minwu85/MQ_Sentinel/CAD/MQ_Sentinel_Encoder_Housing_Dimensions.txt

MQ Sentinel Encoder Housing - Revision 21 (frame unchanged from rev 20; inserts without bars, with wall holes)
All dimensions 1:1 mm (generated by encoder_housing.py, lid.py, motor_ref.py)

OVERALL
Housing height: 133.0 (platform 3 top). With the cap: 170.0 (the 170 mm pipe limit, Appendix 1)
Sensor ring centreline: Z 130.0 (40.0 below the 170.0 top)
Widest part: 160.0 (platform 0, R80)

PLATFORM 0: OD 160.0, thickness 5.0 (Z 0.0 to 5.0)
PLATFORM 1: OD 150.0, thickness 5.0 (Z 5.0 to 10.0), top flat; 10.0 centre hole through both
Underside pockets for the insert plates (2.0 thick; insert_minus1.step, insert_minus2.step):
  Platform -1 plate (Z 0.0 to 2.0): centre circle 50.0 + two wedges at 0 / 180 deg, 60 deg wide
  Platform -2 plate (Z 2.0 to 4.0): centre circle 60.0 + two wedges at 90 / 270 deg, 60 deg wide
  Pocket Z 0.0 to 2.0 is the union of both shapes (plate -2 is fitted from below first)

LOWER POSTS: 4 at 45 / 135 / 225 / 315 deg, 10.0 wide x 14.0 radial, radius 67.5, Z 9.0 to 85.0
PLATFORM 2 (MIDDLE DECK): OD 150.0, thickness 5.0 (Z 85.0 to 90.0)
  X cross: arms on the 45 / 135 deg diagonals, 36.0 wide
  Four axis wedges cut away to R71.0, leaving a 4.0 wide rim (stronger than the old 1.5)
UPPER POSTS: 4 at 45 / 135 / 225 / 315 deg, 10.0 wide x 14.0 radial, radius 67.5, Z 90.0 to 127.0 (37.0 tall)

PLATFORM 3 (TOP SENSOR RING): OD 150.0, ID 120.0, thickness 6.0 (Z 127.0 to 133.0), always complete
  Screw holes: 4 x dia 3.0 at radius 67.5 (45 / 135 / 225 / 315 deg)
  Sensor notches: 3 at 0 / 120 / 240 deg, 8.0 x 7.0 (radial from outer edge) x 6.0 through
  Quarter-turn thread: 4 internal ridge sections centred on 45 / 135 / 225 / 315 deg, each 70 deg wide
    (gaps of 20 deg at 0 / 90 / 180 / 270), pitch 4.0, base radius 60.1, tip radius 58.5

MOTOR SLEEVE: bore 38.0, wall 3.0, OD 44.0, Z 51.0 to 95.0 (44.0 tall), closed 3.0 bottom
  Wire window 10.0 wide x 20.0 tall, front (-Y), Z 54.0 to 74.0

CAP (lid.step), four-section screw cap, Z 123.0 to 170.0
  Top disc: OD 150.0, 4.0 thick (Z 166.0 to 170.0), 4 x dia 3.0 holes at radius 67.5, 20.0 x 8.0 finger slot
  Shell: OD 150.0, wall 3.0, Z 136.0 to 166.0
  Flange on the ring: OD 150.0, 3.0 thick (Z 133.0 to 136.0)
  Threaded skirt: OD 116.0, ID 110.0, Z 123.0 to 133.0 (10.0 long)
  Thread: 4 external ridge sections, each 16 deg wide, pitch 4.0, base radius 57.9, tip radius 59.7
  Drop-in: turn the cap so its sections sit on the axes, push down through the ring gaps, then turn 45 deg
  No raised handle (170 mm limit)

MOTOR (reference, motor_ref.step; measured values)
Overall Z 54.0 to 145.0 (91.0): encoder cap dia 36.0 x 12.0; grey body dia 35.0 x 57.0; boss dia 12.0 x 6.0; shaft dia 6.0 x 16.0
Flywheel dia 100.0 x 10.0, Z 129.0 to 139.0

CHECKS
Interference (all 0.0 mm3): housing/motor, cap/motor, cap/housing seated, cap/housing in drop-in orientation, inserts/housing
Appendix 1: housing + cap 170.0, widest 160.0 (R80)

INSERTS (inserts.py): YOKE PLATFORM -1 (insert_minus1.step) and PLATFORM -2 (insert_minus2.step), v17 form, run after the frame
  Platform -1: round plate dia 50.0 + two 60 deg arms (0 / 180 deg) to R57.0, 2.0 thick, Z 10.0 to 12.0, 10.0 centre hole
  Platform -2: round plate dia 60.0 + two 60 deg arms (90 / 270 deg) to R57.0, 2.0 thick, Z 12.0 to 14.0, 10.0 centre hole
  Curved side walls ("handles"): R54.0 to 57.0, 44 deg wide, up to Z 165.0 (side height 165), 32.0 above the ring top
    (moved in from R66-69 so they pass inside the sensor ring bore R60; narrower to clear the deck X arms)
  Top bars: removed
  Wall holes: 1 hole in each wall (2 per yoke), 20.0 wide x 10.0 tall (2 x 1 cm), for a block through both walls
    Platform -1: Z 150.0 to 160.0 (centre 155.0), in the walls at 0 / 180 deg
    Platform -2: Z 135.0 to 145.0 (centre 140.0), in the walls at 90 / 270 deg; holes of the two yokes are 5.0 apart in height
  Interference with the frame, each other and the motor reference: 0.0 mm3

REVISION 22 (2026-10-24) CHANGES - these override the lines above where they differ
  Posts: 4 lower + 4 upper, 20 x 20 (R55-75, last 5 mm under the ring R60-75); deck rim 15 wide (R60-75) + flange R69-75 z80-85
  Platform 0/1 centre hole 21.0; arc slots R44-55 +-20 deg at 0/90/180/270 (insert walls)
  Motor sleeve: bore 38 z54-85, collar bore 36 z85-97 (top 97, was 95)
  CAP: top z177 (shell z136-173, disc z173-177); keyhole entry dia 10 / slot 5.5 / head pocket 10.4 x 4.5; boss 30 x 60 x 12; 4 ribs 4 x 10;
       8 x dia 3.4 holes (cbore 6.5) at R49.5, +-12 deg from 0/90/180/270; finger slot removed
  INSERTS: plates z0-2 (-1, both shapes) and z2-4 (-2), arms to R80 (160 wide), hole 21; walls R44.5-54.5 +-19 deg, top z173 (R50.5-54.5 at z127-141);
       belts R34.5-44.5 at z14-34, 100-120, 147-167; 20 x 10 holes (z150-160 / z135-145); 2 pilot holes dia 2.6 in each wall top
  LASER STRAW: A hollow bolt (flange 34 z10-13, tube OD 18/20 thread, bore 10, z-14 to 10); B nut dia 34 z-10 to 0, pitch 2.5
  Interference (all 0.0 mm3): every pair of housing, cap, inserts, straw parts, motor/flywheel reference

REVISION 23 (2026-10-24, second pass) - overrides revision 22 where it differs. 4 parts: lid, encoder_housing, insert, laser
  CAP: top z197 (disc z191-197), shell z136-191, no holes, no inner support; 4 ears R70-91.3 +-12 deg on the diagonals with 1 x dia 3.4 hole each (R85.3);
       arch hanger on a 44 x 18 x 3 pad: 32 wide, legs 8, 10 thick, opening 16 x 14, top z222
  ENCODER: arc slots removed; pocket under platform 0 = circle 60 + 4 arms +-30 deg on 45/135/225/315, 4 deep;
       centre socket hole R10.4 (z0-10) with female ridge z4-10, pitch 2.5, root R10.4, tip R8.4
  INSERT (one part): plate 4 thick (circle 60 + 4 arms to R90.3), hole dia 20.8; 4 walls R80.3-90.3, +-9 deg at 45/135/225/315, z0-190.7; pilot dia 2.6 x 15 at R85.3
  LASER: stub core R8 / ridge R10, bore 8, z0-10; flange dia 30 z-3..0; column dia 20; tube along +X OD 16.5, bore 10.5, 70 long, axis z-16; points at 0 deg (sensor 1)
  Interference (all 0.0 mm3): housing, lid, insert, laser, motor/flywheel reference, 172 mm pipe on platform 0

REVISION 24 (2026-10-25) - overrides revision 23 where it differs
  CAP: flange 6 thick (z133-139), 4 pilot holes dia 2.6 at R63.5, 0/90/180/270; ears R73-91.3 +-10 deg at z177.3-183.3, hole dia 5.5 (cbore 10) at R85.3;
       hanger pad 24 x 10 x 3, block 18 x 8 x 14, keyhole dia 8 + slot 4.5; top z197, hanger top z214
  ENCODER: upper posts R60-75 (z90-127); ring holes dia 3.4 at R63.5, 0/90/180/270 (plus the original 4 at R67.5, 45 deg)
  INSERT: walls +-7 deg, z0-177, pilot dia 4.2 x 20 at R85.3
  LASER: tube axis z-20 (150 below the ring centreline z130), slot 6 x 42 on top, grub hole at x63

REVISION 25 (2026-10-25, second pass) - overrides revision 24 where it differs
  RING + CAP FLANGE: 3 holes dia 5.5 at R67.5, 60/180/300 deg (old 45 deg and 0/90/180/270 holes removed); cap ears +-13 deg
  INSERT: walls +-10 deg; mid ring R80.3-90.3 z78.5-98.5; plate hole with female thread z0-4 (same helix as the encoder socket z4-10)
  LASER: side window 6 x 42 through both sides at the axis (z-20), plus the top slot

REVISION 26 (2026-10-25, third pass) - overrides revision 25 where it differs
  INSERT: walls 45 mm wide (+-15.3 deg at R85.3) at 45/150/210/315 deg; plate arms +-20 deg at the same angles; thread in the plate hole z0-4 (153 mm3)
  ENCODER: underside pocket arms +-20 deg at 45/150/210/315; socket thread z4-10 (230 mm3); ring holes unchanged (60/180/300)
  CAP: ears +-18.5 deg at 45/150/210/315
  LASER: top slot removed; side window and grub hole only

REVISION 27 (2026-10-25): laser = v25 (top slot + side window), stub top z13 (3 mm lead-in); all other parts as revision 26

REVISION 28 (2026-10-30)
  ENCODER: height 140; sensor ring z134-140 (centre z137 = 40 below the pipe top z177); upper posts z90-134
  CAP: seat z140 (flange z140-146), top z197 unchanged, ears z177.3-183.3 unchanged
  INSERT: wall + mid ring R81.3-90.3 (was R80.3)
  LASER: tube axis z-13 (150 below the ring centre)
