minwu85/MQ_Sentinel/src/flowchart.md

## Appendix H — Individual Contribution Graph

Min:

```text
WEEK 1–2
│
├── Scrum / project organisation
├── Arduino / C++ / PlatformIO setup
├── Software approach investigation
└── Initial project documentation
|      │
       ▼
WEEK 3
│
├── Motor / encoder testing
├── Motor connectivity test
├── Continuous motor control
└── Hardware-independent software structure
└── Scrum/project documentation
        │
        ▼
WEEK 4
│
├── Motor direction control
├── Motor speed / PWM control
├── Motor-driver troubleshooting
├── IR-reactive motor control
└── IR trigger / transmitter-receiver test
└── Scrum/project documentation
        │
        ▼
WEEK 5
│
├── Arduino Uno backup development
├── IR-reactive testing
├── IR-triggered motor testing
├── Three-sensor directional control
├── Technical documentation
└── Scrum/project documentation
        │
        ▼
PROTOTYPE V1
│
└── Software foundation:
      IR sensing
          ↓
      Decision logic
          ↓
      Motor direction/speed
          ↓
      Physical prototype integration

```
**Figure H2. Individual software and project-documentation contribution progression across Weeks 1–5.**
