minwu85/MQ_Sentinel/CAD/insert.step

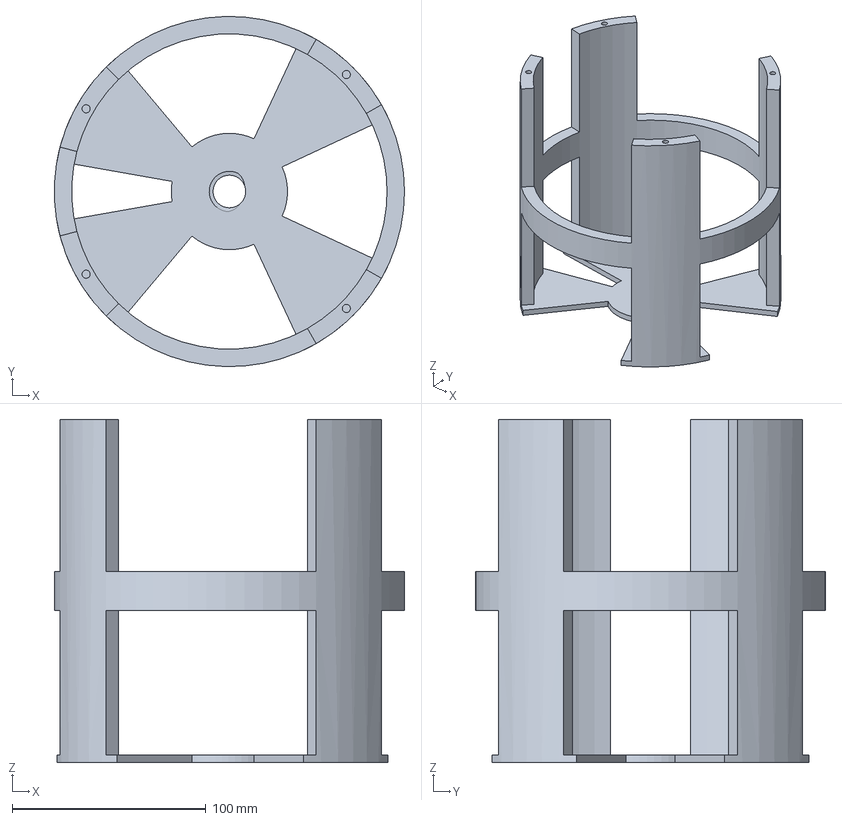
[picture p1: CAD file, 2026-10-30]
CAD/insert.step
180.5 x 180.6 x 177.0 mm
