minwu85/MQ_Sentinel/CAD/reference/motor_ref.step

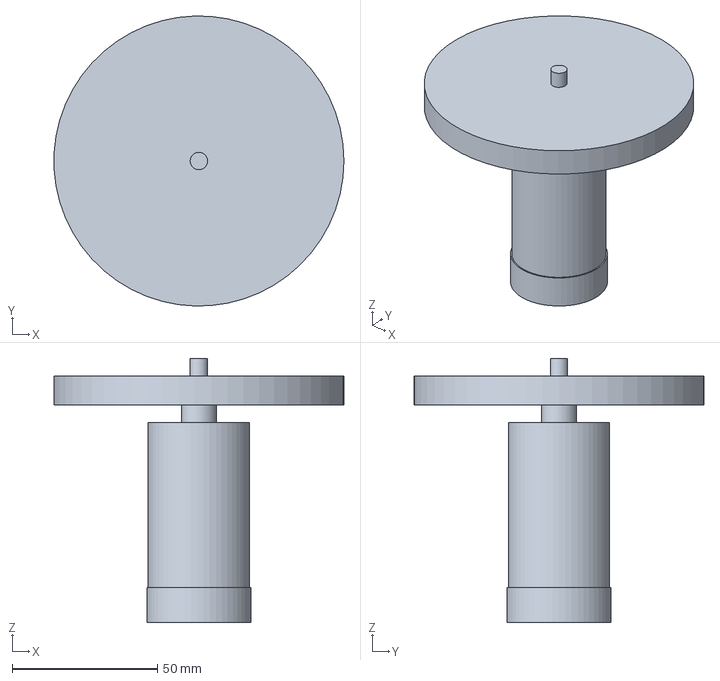
[picture p2: CAD file, 2026-10-24]
CAD/reference/motor_ref.step
99.9 x 100.0 x 91.0 mm
