minwu85/MQ_Sentinel/CAD/senitelmodel/Model.step

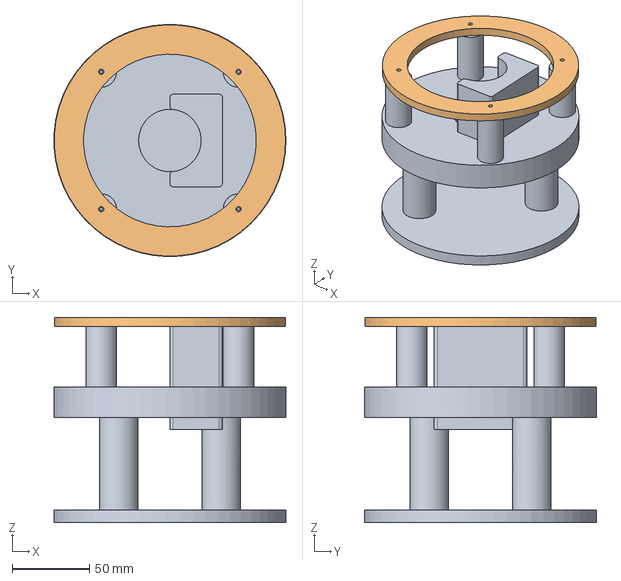
[picture p3: CAD file, 2026-10-06]
CAD/senitelmodel/Model.step
150.5 x 150.5 x 133.0 mm
Lower_Chassis_60mm_Gap
Sensor_Ring
