minwu85/MQ_Sentinel/CAD/laser.step

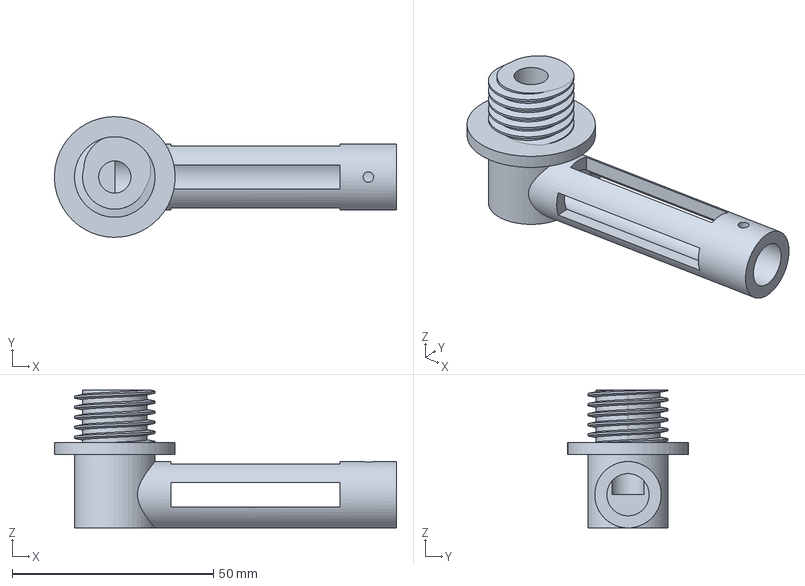
[picture p4: CAD file, 2026-10-30]
CAD/laser.step
85.0 x 30.0 x 34.2 mm
