minwu85/MQ_Sentinel/CAD/lid.step

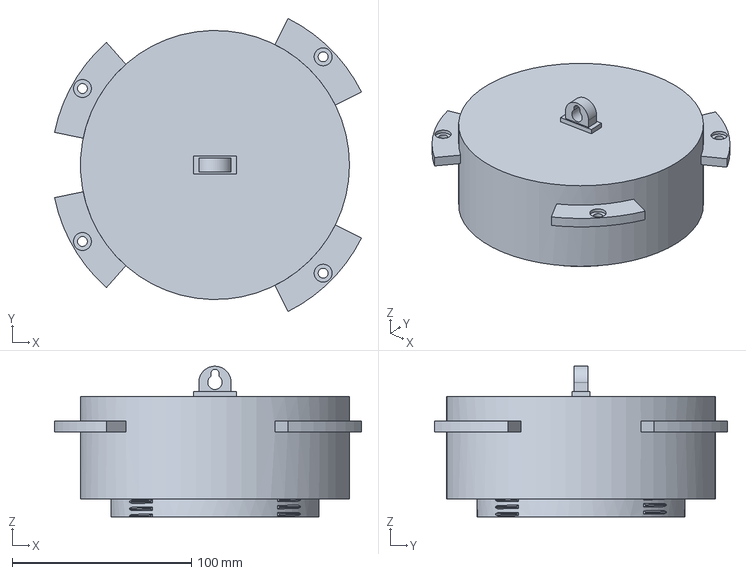
[picture p5: CAD file, 2026-10-30]
CAD/lid.step
171.2 x 163.4 x 84.0 mm
