minwu85/MQ_Sentinel/CAD/encoder_housing.step

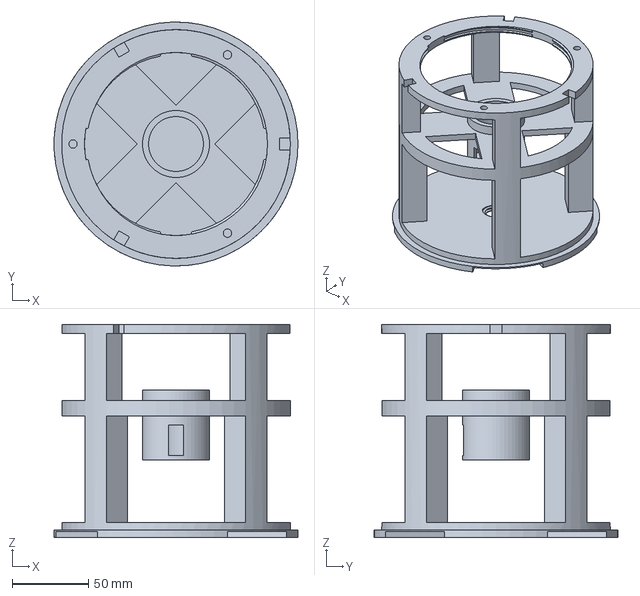
[picture p6: CAD file, 2026-10-30]
CAD/encoder_housing.step
160.0 x 160.0 x 140.0 mm
