minwu85/MQ_Sentinel/CAD/laser_straw_b.step

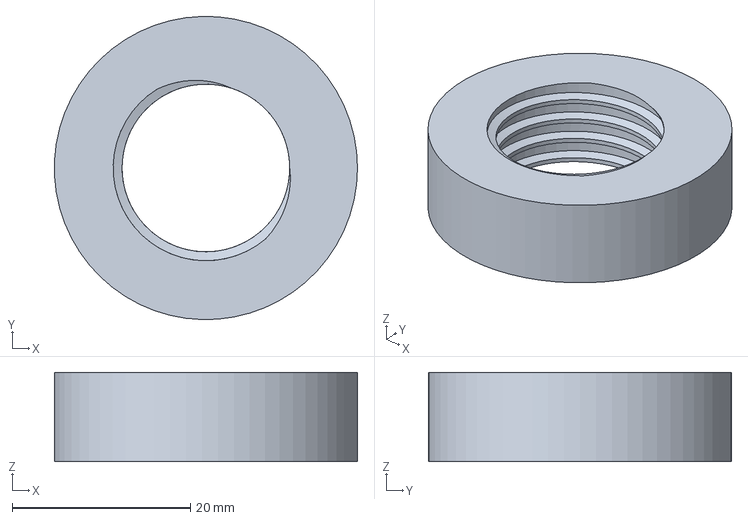
[picture p7: CAD file, 2026-10-23]
CAD/laser_straw_b.step
34.0 x 34.0 x 10.0 mm
