minwu85/MQ_Sentinel/CAD/insert_minus1.step

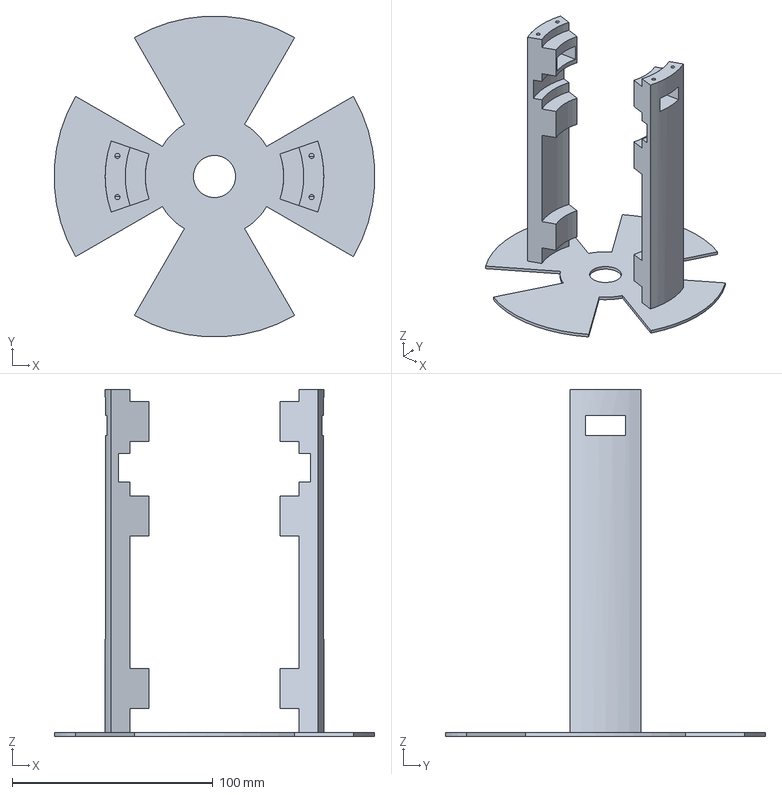
[picture p8: CAD file, 2026-10-23]
CAD/insert_minus1.step
159.7 x 159.7 x 173.0 mm
