minwu85/MQ_Sentinel/CAD/insert_minus2.step

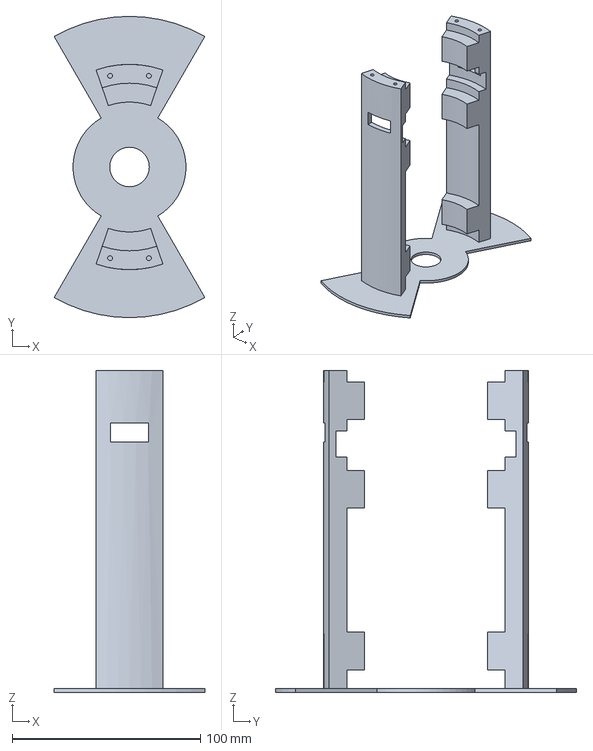
[picture p9: CAD file, 2026-10-23]
CAD/insert_minus2.step
80.0 x 160.0 x 171.0 mm
