minwu85/MQ_Sentinel/CAD/laser_straw_a.step

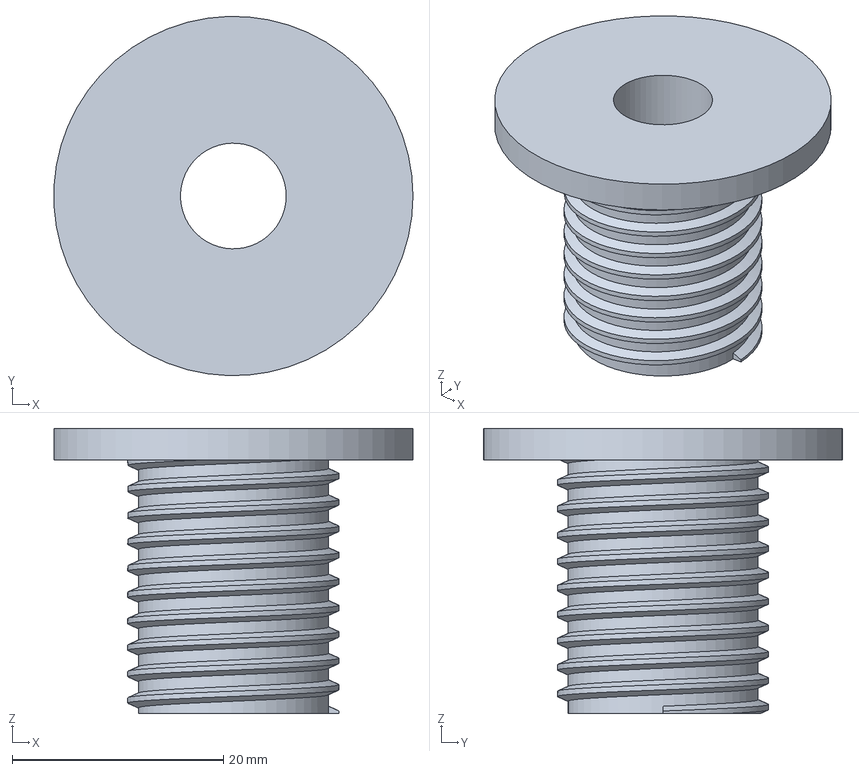
[picture p10: CAD file, 2026-10-23]
CAD/laser_straw_a.step
34.0 x 34.0 x 27.0 mm
