minwu85/MQ_Sentinel/CAD/motor_tube.step

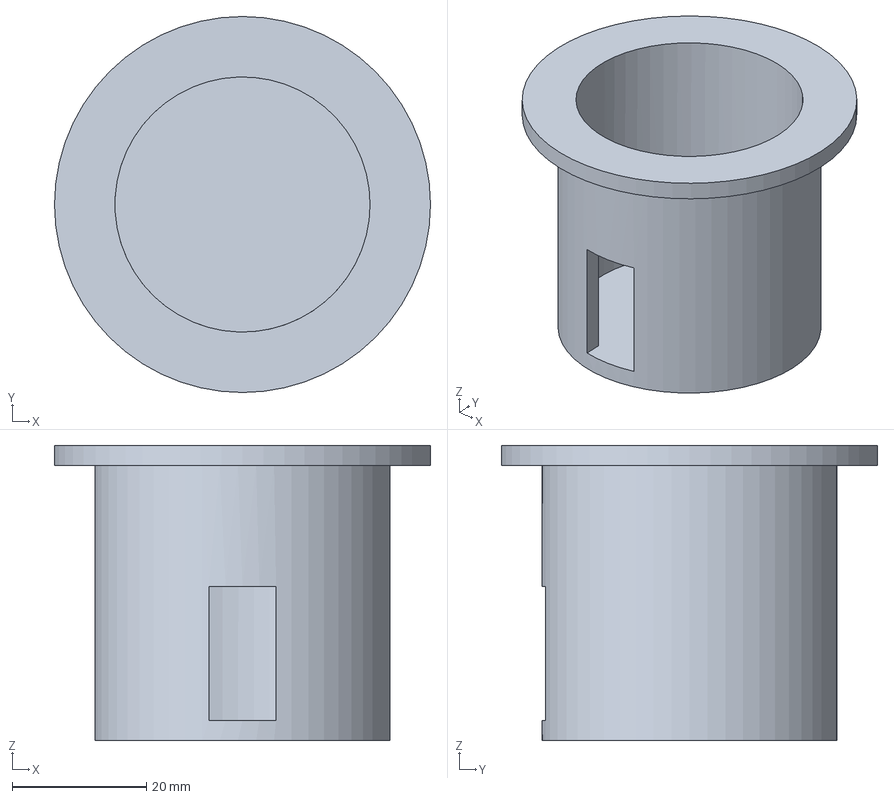
[picture p11: CAD file, 2026-10-19]
CAD/motor_tube.step
56.0 x 56.0 x 44.0 mm
