minwu85/MQ_Sentinel/(list of files, cad)

Other CAD files:
CAD/motor_ref.step
CAD/encoder_housing.stl
CAD/lid.stl
