minwu85/MQ_Sentinel/(commit log)

2026-08-14 update nano connected to motor
2026-08-21 add motor spin withour usb
2026-08-21 update md for autonomous spin for motor without usb
2026-08-21 add laser code
2026-08-21 add laser test
2026-08-26 update: motor test for uno, autospin, control, LED
2026-08-27 add: split uno/nano, update motor spin, reactivIR+motortest
2026-08-27 add: ir transmitter, motor spin without usb, reactive ir
2026-08-28 Add Arduino code for 3-sensor directional control
2026-08-28 update: change the pin preious
2026-08-28 add: explain for 3 sensor IR
2026-08-30 update: md flowchart.md
    Added a detailed contribution graph outlining activities over five weeks, including Scrum participation, development tasks, and documentation efforts.
2026-08-30 update: md flowchart
2026-09-11 update mpu6050 gyro in cpp at uno folder
2026-10-06 feat: CAD
    [encoder_housing.step, encoder_housing.stl]
2026-10-06 update: 3d module all issues fix
    [Model.step, encoder_housing.step, encoder_housing.stl]
2026-10-07 feat: create lid and add gap for the sensor for the module
    [encoder_housing.step, encoder_housing.stl, lid.step, lid.stl]
2026-10-08 feat: motor continue spin then detect stop, and add new ir sensor test spin_until_ir_main.cpp: motor runs continuously and stops when D4/D5/D6 reaches ≥5 LOW readings within 100 ms. Debouncing/restar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
    Run the sensor test with the beacon off/on and at ±45°.
    Measure actual motor RPM rather than assuming MOTOR_SPEED =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
    [ir_sensor_test_main.cpp, spin_until_ir_main.cpp]
2026-10-08 feat(rotating_detect): add 3-sensor rotating detection environment Add new Arduino/PlatformIO rotating_detect environment with three IR sensors on D4/D5/D6 at 0°/120°/240°, encoder tracking on D2/D3,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
    [laser_test_main.cpp]
2026-10-08 feat(spin_detect): integrate continuous scan, target tracking and MPU6050
    Combine motor_onoff, spin_until_ir, laser control, encoder tracking, and MPU6050 gyro support into one spin_detect program. The system auto-starts scanning at the existing speed of 200, keeps the laser ON during scanning/target rotation/5-second hold, detects only after the same K=5 threshold and 200 ms clear time used by spin_until_ir, and requires the same sensor to trigger for 3 consecutive windows before accepting a target.
    On confirmed detection, stop the motor first, record encoder position, gyro angle, sensor ID, and calculated bearing, then calculate angle_error = wrap180(bearing - laser_axis) to select the sh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
2026-10-08 feat(spin_detect): fix laser state and add fully automatic single-sensor mode
    Fix spin_detect so the laser remains OFF during scanning, optional target alignment, pauses, faults, and startup, and turns ON only after a confirmed detection when the motor has stopped. Keep the laser ON for the 5-second hold, then turn it OFF before scanning resumes. Preserve existing detection filtering, encoder/MPU6050 tracking, geometry, shortest-path rotation, fault handling, and re-arm logic, with ALIGN_ENABLED=false by default for early bench testing.
    Add compact 500 ms telemetry to both environments showing MPU6050 acceleration, gyro rate, temperature, encoder count/angle, gyro angle, detection signal/co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
    [spin_detect_one_main.cpp]
2026-10-08 fix(spin_detect): rotate to detected target before laser hold
    Update spin_detect and spin_detect_one so a confirmed detection now follows the sequence: detect → stop → calculate target bearing → rotate shortest path onto target → stop → laser ON → hold 5 s → laser OFF → resume scanning.
    Remove MULTI_SENSOR as a fault condition. When multiple sensors detect the beacon, compare their LOW counts across the three confirmation windows and select the strongest sensor, using its first-seen position for the bearing.
    Improve MPU6050 startup by waiting for the assembly to become stationary before performing the bias check, retrying every second for up to 10 s, with one additional ret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
    [spin_detect_main.cpp, spin_detect_one_main.cpp]
2026-10-08 refactor(spin_detect): simplify detection and target-centering logic - final
    Rewrite spin_detect from scratch using spin_until_ir as the base. Remove encoder tracking, gyro angle/bearing calculations, and fault-state logic to eliminate the previous stopping and calibration failures. The new system scans clockwise with the laser OFF, reads S1/D4, S2/D5, and S3/D6 in 100 ms windows using the existing K=5 detection threshold, and uses the detecting sensor to determine the correction direction: S2 turns CW, S3 turns CCW, while S1 represents the laser-axis/centre position and stops the motor when detected. If S1 is already the strongest signal, the system stops immediately.
    After detection, stop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
    [spin_detect_main.cpp]
2026-10-08 feat(spin_detect): add single-sensor mode and PID rotation variant
    Update spin_detect_one to use the same simplified detection logic as spin_detect with a single D6 sensor on the laser axis. It scans clockwise with the laser OFF, stops on detection, turns the laser ON for 4 seconds, turns it OFF, resumes scanning, and requires 200 ms of clear signal before re-arming. Remove the turn-to-target step because there is no secondary sensor for directional correction. Keep 115200-baud telemetry with S1(D6), accelerometer, gyro, and scan-state information.
    Add new spin_detect_clock based on spin_detect with PID-controlled target centering. Use D6 as the centre/laser-axis sensor, D4 as the anti-cloc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
    [spin_detect_clock_main.cpp, spin_detect_one_main.cpp]
2026-10-08 fix(spindetectclock): stop immediately when centre sensor leads
    Rewrite the spin_detect_clock stopping logic so target centering is evaluated every 10 ms using a rolling 50 ms sensor count instead of waiting for multiple conditions to align at 50–100 ms intervals. Compare D6 directly against the stronger of D4/D5; if D4 is stronger, turn D6 anti-clockwise, and if D5 is stronger, turn D6 clockwise. Once D6 is the strongest sensor for 3 consecutive 10 ms slices (30 ms), stop the motor immediately, turn the laser ON for 4 seconds, then turn it OFF and resume scanning.
    Simplify the PID role so it controls only turn speed based on the difference between the strongest side sensor and D6: larger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
    [spin_detect_clock_main.cpp]
2026-10-09 feat: rewrite spindetectclock stop logic as v0.3
    Restore v0.1 clock PID rotation using normalized D4/D5/D6 position error.
    Replace five-condition stop test with adaptive dead band and zero-crossing detection.
    Require 3 consecutive 10 ms slices to confirm stopping.
    Add 1.8 s hard stop and laser trigger while the message remains on the sensors.
    Remove the requirement for a strong D6 signal and warn if D6 receives no signal.
    Preserve scanning, 4 s laser-on stop, laser-off sequence, and Acc/Gyro output.
    Add simulation comparisons for v0.1, v0.2, and v0.3.
    Document implementation, process, stopping logic, mathematical analysis, and future development.
    Update RE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
    [spin_detect_clock_main.cpp]
2026-10-09 feat: slow motor operation and synchronize laser with motor state
    Update spin_detect to v1.1 and spin_detect_clock to v0.5.
    Reduce scan PWM from 200 to 130 in both programs.
    Reduce spin_detect turn PWM from 150 to 110.
    Reduce spin_detect_clock turn PWM range from 110–200 to 100–140.
    Turn the laser ON when the motor stops and OFF before the motor starts.
    Keep the laser ON at power-up and prevent brief flashes during direction reversals.
    Scale clock turn hard limit from 1.5 s to 3 s.
    Extend dead-band widening from 1.2 s to 2.4 s.
    Increase re-arm delay from 0.7 s to 1.5 s.
    Verify stopping logic in simulation with slower motor settings.
    Update spin_detect.md and add Part 4, including maths a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
    [spin_detect_clock_main.cpp, spin_detect_main.cpp]
2026-10-09 Revise MPU6050 section with detailed calculations
    Updated section titles and added detailed calculations for MPU6050 measurements, including mean acceleration, resultant acceleration magnitude, and gyroscope values.
2026-10-16 feat: add ONE IR sensor (TSOP4138 on D4) works - Nano V3 test code@
2026-10-19 feat: Motor and flywheel, Motor centring, Posts rectangular All six changes are in the model. The script exports one valid solid, 160 × 160 × 135 mm, and the housing, lid and a motor/flywheel referen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
    Files in CAD/: encoder_housing.step, lid.step, motor_ref.step (a stand-in for the motor and flywheel, not for printing), VERSION_LOG.md and MQ_Sentinel_Encoder_Housing_Dimensions.txt.
    Version log: VERSION_LOG.md covers v1 to v9 with each issue and its fix. It has an outline drawing and a table naming every part, such as Platform 1 (base), Platform 2 (middle deck), Platform 3 (top ring), lower and upper posts, motor clamp and lid skirt. I saved a note to keep u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
2026-10-19 feat: Full-round motor sleeve, Ring thread remove scraw, Bottom platform I’ve updated the housing with all three changes. The script exports one valid solid, 160 × 160 × 135 mm, with no overlap again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
    Full-round motor sleeve:
    There is now a full-circle tube (46 mm outside, 40 mm bore, 47 mm tall) under platform 2. It holds the black encoder (15 mm) and 32 mm of the grey body, and the 40 mm hole in platform 2 is a full circle.
    The motor now sits 5 mm lower, with its bottom at z 28.
    I read “under the platform 3” as platform 2, the middle deck.
    I added a 20 × 10 mm wire window at the bottom front of the slee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
2026-10-19 feat: Platform 3 (top sensor ring, Platform 2 (middle deck), Platform 1 (base) I’ve rebuilt the housing with the platform numbers corrected. The script exports one valid solid, 160 × 160 × 135 mm, wi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
    I numbered the platforms bottom to top: 1 is the base, 2 is the middle deck, 3 is the top ring.
    Platform 3 (top sensor ring):
    It is a complete ring again (150 mm outside, 120 mm inside). I’ll treat it as never removable.
    A plus-shaped cross of 30 mm wide arms sits inside the ring, with the corner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
2026-10-19 feat: Pattern on the underside of the bottom layer, Open top, motor, tube encorder I’ve made all three fixes. The script exports one valid solid, 160 × 160 × 135 mm, with no overlap against the motor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
    image labels as 1 = the thin 160 mm bottom layer, 2 = the 5 mm base disc, 3 = the middle deck and 4 = the top ring. That is the reading I worked from.
    Pattern on the underside of the bottom layer:
    It is now cut into the bottom face, 2 mm deep. The base disc’s top face is flat, with only the 10 mm centre hole.
    The pattern is still the 50 mm centre circle plus two opposite 60° wedg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
2026-10-19 feat: Bottom layer, Motor tube, Middle deck rim I’ve updated the model with all three changes. The script exports one valid solid, 160 × 160 × 135 mm, with no overlap against the motor and flywheel s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
    Bottom layer:
    Layer 0 (160 mm) is now 5 mm thick, up from 1 mm. It lines up with the 150 mm base disc, so the base is effectively one 160 mm, 5 mm thick disc.
    The 2 mm underside pattern (centre circle and the two opposite wedges) now runs out to the 160 mm edge.
    I took the “unwanted part” you marked to be the thin leftover rim at the wedges, and it i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
2026-10-19 feat: rim, Four-section screw cap, Handle I made the changes below. The housing and the cap are each one valid solid. There is no overlap between the housing, the cap (seated and in drop-in position)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
    The second point of your request (“Based on the document information provided I want to make…”) was cut off, so I didn’t act on it. I noted the project brief in the version log and haven’t modelled a laser pointer mount. Tell me what you wanted there.
    Rim: I assumed “encord” meant the thin rim arcs you circled on the middle deck. They are now 4 mm wide (R71 to R75),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
2026-10-19 feat: Ring and lid, Yokes (platform -1 and -2), Motor tube I’ve redesigned the inserts as the cage from your images 1 to 3 and made the sensor ring inside flat. I haven’t looked at it in a viewer. A 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
    Ring and lid
    The thread is gone, so the sensor ring is a plain complete ring with its notches and holes.
    I dropped the cap. lid.py and lid.step are left as they were and no longer fit, and I haven’t deleted them.
    Yokes (platform -1 and -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
2026-10-19 feat: Design, Height, Circle parts, Tube I left encoder_housing.step as it was (v16) and rebuilt insert_minus1.step and insert_minus2.step. I haven’t looked at the inserts in a viewer. Both are valid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
    Design: I brought back the v17 form: a round plate on platform 1, two curved side walls, and a top bar. Yoke -1 lies along 0° and 180°, yoke -2 along 90° and 270°. The bars sit off-centre and cross with a half-lap notch. The 10 mm centre hole is back.
    Height: I read “172 mm long section of 160 mm” as the size limit, so the inserts are not 172 mm tall. Both yokes top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
2026-10-19 feat: Frame (v16), Inserts, Wall position I’ve made both changes.The frame is one valid solid (160 × 160 × 133 mm), both yokes are valid solids, and nothing overlaps (frame, yokes, motor stand-in).
    Frame (v16)
    Platform 0 is now 5 mm thick. Nothing else in the v16 frame changed.
    Platform 1 now sits at z 5–10, and the lower posts are 3 mm longer so they still meet the same deck and ring heights.
    Inserts
    I went back to the v17 yokes, with the plates on the new platform 1 at z 10–12 and z 12–14. The plate sizes, the 10 mm hole and the top bars at z 90–95 are as in v17.
    The curved side walls (your green circles) now go up to z 165. That puts them 32 mm above the top ring, so they w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
2026-10-19 feat: Green area removed, hole, insert I removed the green area from both inserts and added two block holes to each, but I haven’t looked at the files in a viewer. encoder_housing.step was not touche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
    Green area removed: the top bars and their turned-in ends are gone. Each insert is now a round plate with two curved walls, up to z 165.
    Holes:
    Each insert has one 2 × 1 cm hole (20 mm wide, 10 mm tall) in each of its two walls, placed at the top where you marked.
    A block can pass straight through both walls of an insert.
    I checke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
2026-10-23 feat: wk11 update cad encord, Lid, walls, insert, Laser straw, Wall thickness, Sensor ring, keyhole, Laser fit All six items are modelled, and all parts are valid single solids with 0 mm³ overlap bet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
    Frame (item 1):
    Deck rim: I read the weak ring in image 7 as the platform 2 rim. It is now 15 mm wide (was 4 mm), with a small flange under it.
    Posts: now 20×20 mm. The last 5 mm under the sensor ring is stepped back to R60, because the lid skirt sits there.
    Motor centring: I applied the 1 mm radius reduction to a collar from the deck up (bore 36, top raised 2 mm). The encoder zone from plat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
2026-10-24 feat: add image version v22 changes in VERSION_LOG.md
    Updated version log with detailed changes for frame, lid, inserts, and new laser straw components.
2026-10-24 feat: lid, encord, laser, insert, v23 The CAD folder now has four print parts: lid.step, encoder_housing.step, insert.step and laser.step. All are valid single solids, and none overlaps any other par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
    Lid:
    Holes and support: all the holes are filled and the inner boss and ribs are removed.
    Hanger: the keyhole is replaced by a raised arch loop on a small pad, with the top disc thickened to 6 mm.
    Height: the top is z197, 20 mm above the pipe top (z177).
    Screw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
2026-10-24 feat: add cad v23 image
2026-10-24 feat: update v24 cad image
2026-10-24 feat: lid, laser, encord, insert v24 cad All four parts are updated to v24 and logged in VERSION_LOG.md and the dimensions file. Every part is a valid solid with 0 mm³ overlap against the others, the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
    Lid
    Hanger: it is now a small block (18 wide, 8 thick, 14 tall) on a 24×10 pad. The keyhole is flipped as in your reference: round hole at the bottom, narrow slot above.
    Ears: I moved them from the very top down to just above the pipe top (z177.3–183.3), so they are outside the lid body and reachable from above. Their holes are bigger, M5 (5.5 mm). The lid top is still z197, 20 mm over the pipe.
    Ring fixing: I read the lid-bottom holes request as four equa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
2026-10-24 feat: v25 cad image
2026-10-24 feat: Lid and encoder ring holes, insert, thread, v25 cad I’ve made the holes-only changes and the four parts are updated to v25. All parts are valid with 0 mm³ overlap, including the laser thread ag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
    Lid and encoder ring holes:
    Count and position: both now have 3 equal holes at 60°, 180° and 300°, which is 60° from the sensors at 0°, 120° and 240°. The old holes, including the one beside a sensor, are gone.
    Size: 5.5 mm for M5 (was 2.6 mm in the lid and 3.4 mm in the ring). The lid hole goes through the 6 mm flange.
    Placement: I moved them out to R67.5 so a bigger hole doesn’t touch the thread ridge. This is my reading of your green-holes imag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
2026-10-25 feat: v26 cad image
2026-10-25 feat: v26 cad thread, Insert walls, Laser The screw structure you couldn’t see in the encoder’s bottom hole was missing, and it is now fixed. All four parts are re-exported as v26, with every part va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
    Threads: the thread I reported in the encoder and insert hole in the last few versions was never actually in the model. The boolean silently added nothing, and my overlap checks didn’t catch it. Both holes now measure as threaded: 230 mm³ of thread in the encoder (z4–10) and 153 mm³ in the insert plate (z0–4). The laser stub screws through the plate into the encoder, so one laser joins the insert and encoder: 5 mm of thread in platform 0 (pla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
2026-10-25 feat: v27 cad image
2026-10-25 feat: v27 laser The laser is back to v25 (top slot plus the side window in your red box, which I haven’t touched), and the blue thread section is 3 mm longer. All six solids are valid with 0 mm³ over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
    Laser hole in the green section: I couldn’t find a rectangular hole in the vertical column of the v25 laser. The only openings are the top slot, the side window, the small screw hole and the internal wire bore. I removed nothing there, so tell me which hole you mean.
    Screw check: I simulated screwing the laser out of its seated position for two full turns. It stays clear of the insert and the encoder at every step, so it does screw through the insert and into the enco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
2026-10-30 feat: v28 cad module update meansure base on the requirment
    - Insert wall: the inner face of the walls and of the ring around them moved 1 mm out, from R80.3 to R81.3. That leaves 1.3 mm clear of the pipe. I kept the outer R90.3, the wall width, the plate, the arms and the pilot holes, so each wall is now 9 mm thick. I lowered the pipe through the insert from 40 mm above to seated, and it never touched.
    - Sensor ring: I raised the ring 7 mm, to z134–140, so its centre is z137. That is 40 mm below the top of a 172 mm pipe sitting on platform 0, which tops out at z177. I measured this on the exported file. It was 47 mm below the top before.
    Knock-on from the ring move:
    - Encoder: the four up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
